cjsatuforc/MiniMega2560/2560v10_2e_3vREG.jpg

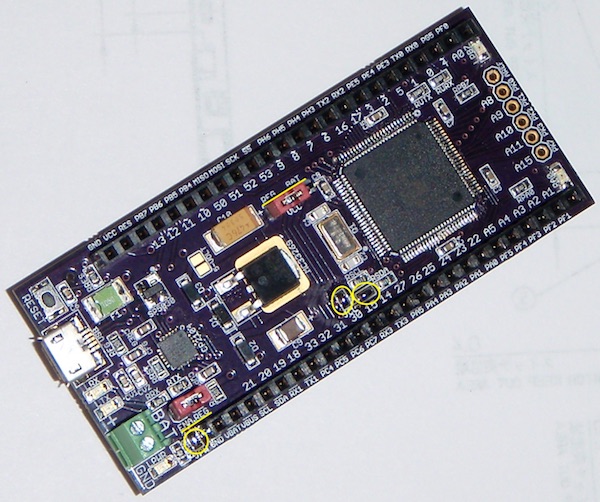
2560v10_2e_3vREG.jpg
