cjsatuforc/MiniMega2560/2560v10_2e_5volt.jpg

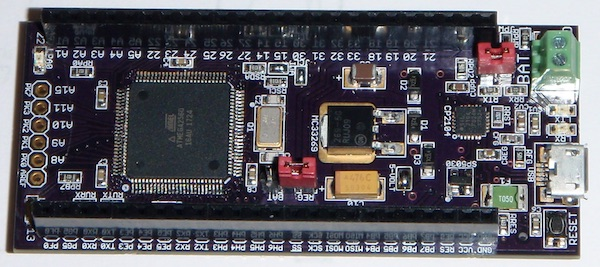
2560v10_2e_5volt.jpg
