cjsatuforc/MiniMega2560/2560v10_2e_NoReg.jpg

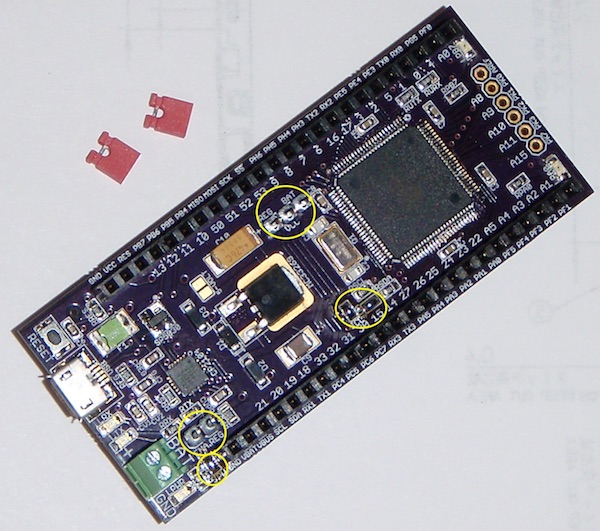
2560v10_2e_NoReg.jpg
