cjsatuforc/MiniMega2560/MiniMega2560NetCardPoE.jpg

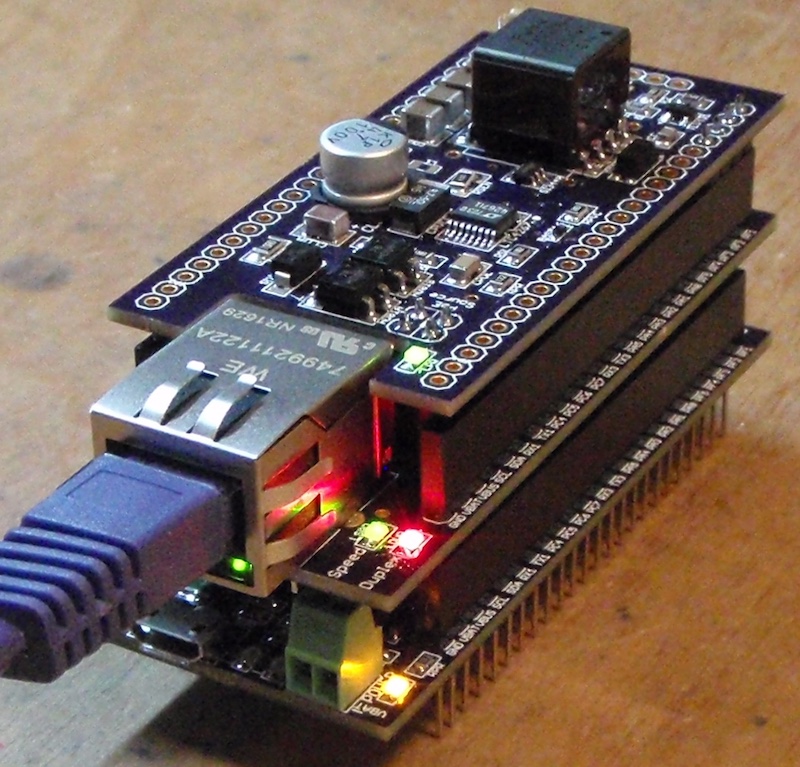
MiniMega2560NetCardPoE.jpg
