cjsatuforc/MiniMega2560/sleep/2560_2e_Battery.jpg

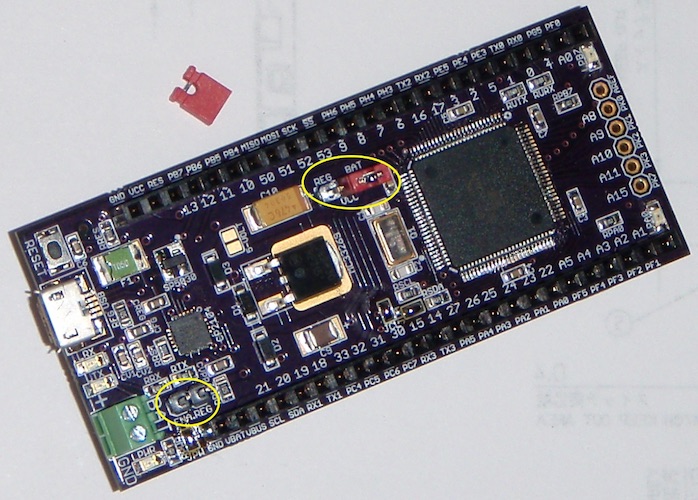
sleep/2560_2e_Battery.jpg
