cjsatuforc/MiniMega2560/sleep/sleep_pix1_ma.jpg

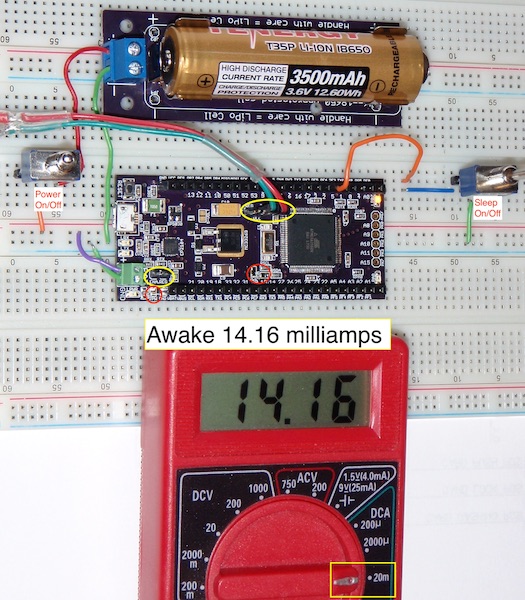
sleep/sleep_pix1_ma.jpg
