cjsatuforc/MiniMega2560/sleep/sleep_pix2_ua.jpg

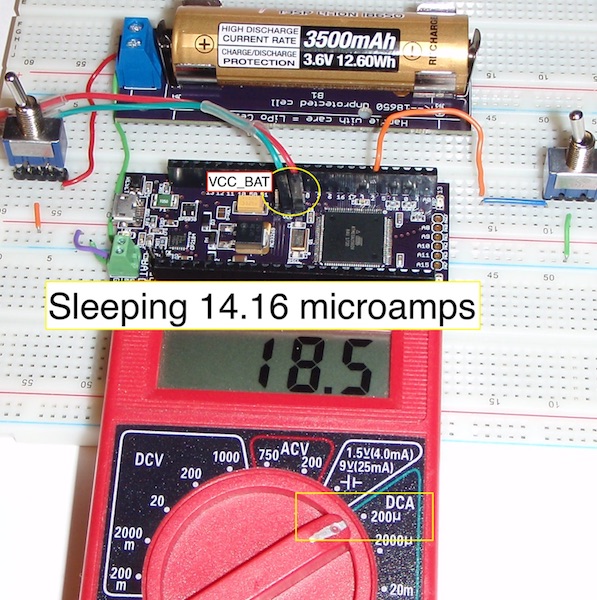
sleep/sleep_pix2_ua.jpg
