cjsatuforc/MiniMega2560/vcc_to_href_jumper.jpg

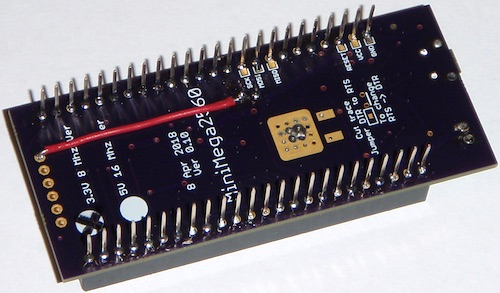
vcc_to_href_jumper.jpg
