cjsatuforc/MiniMega2560/MiniMega2560v10_2e.SC.pdf

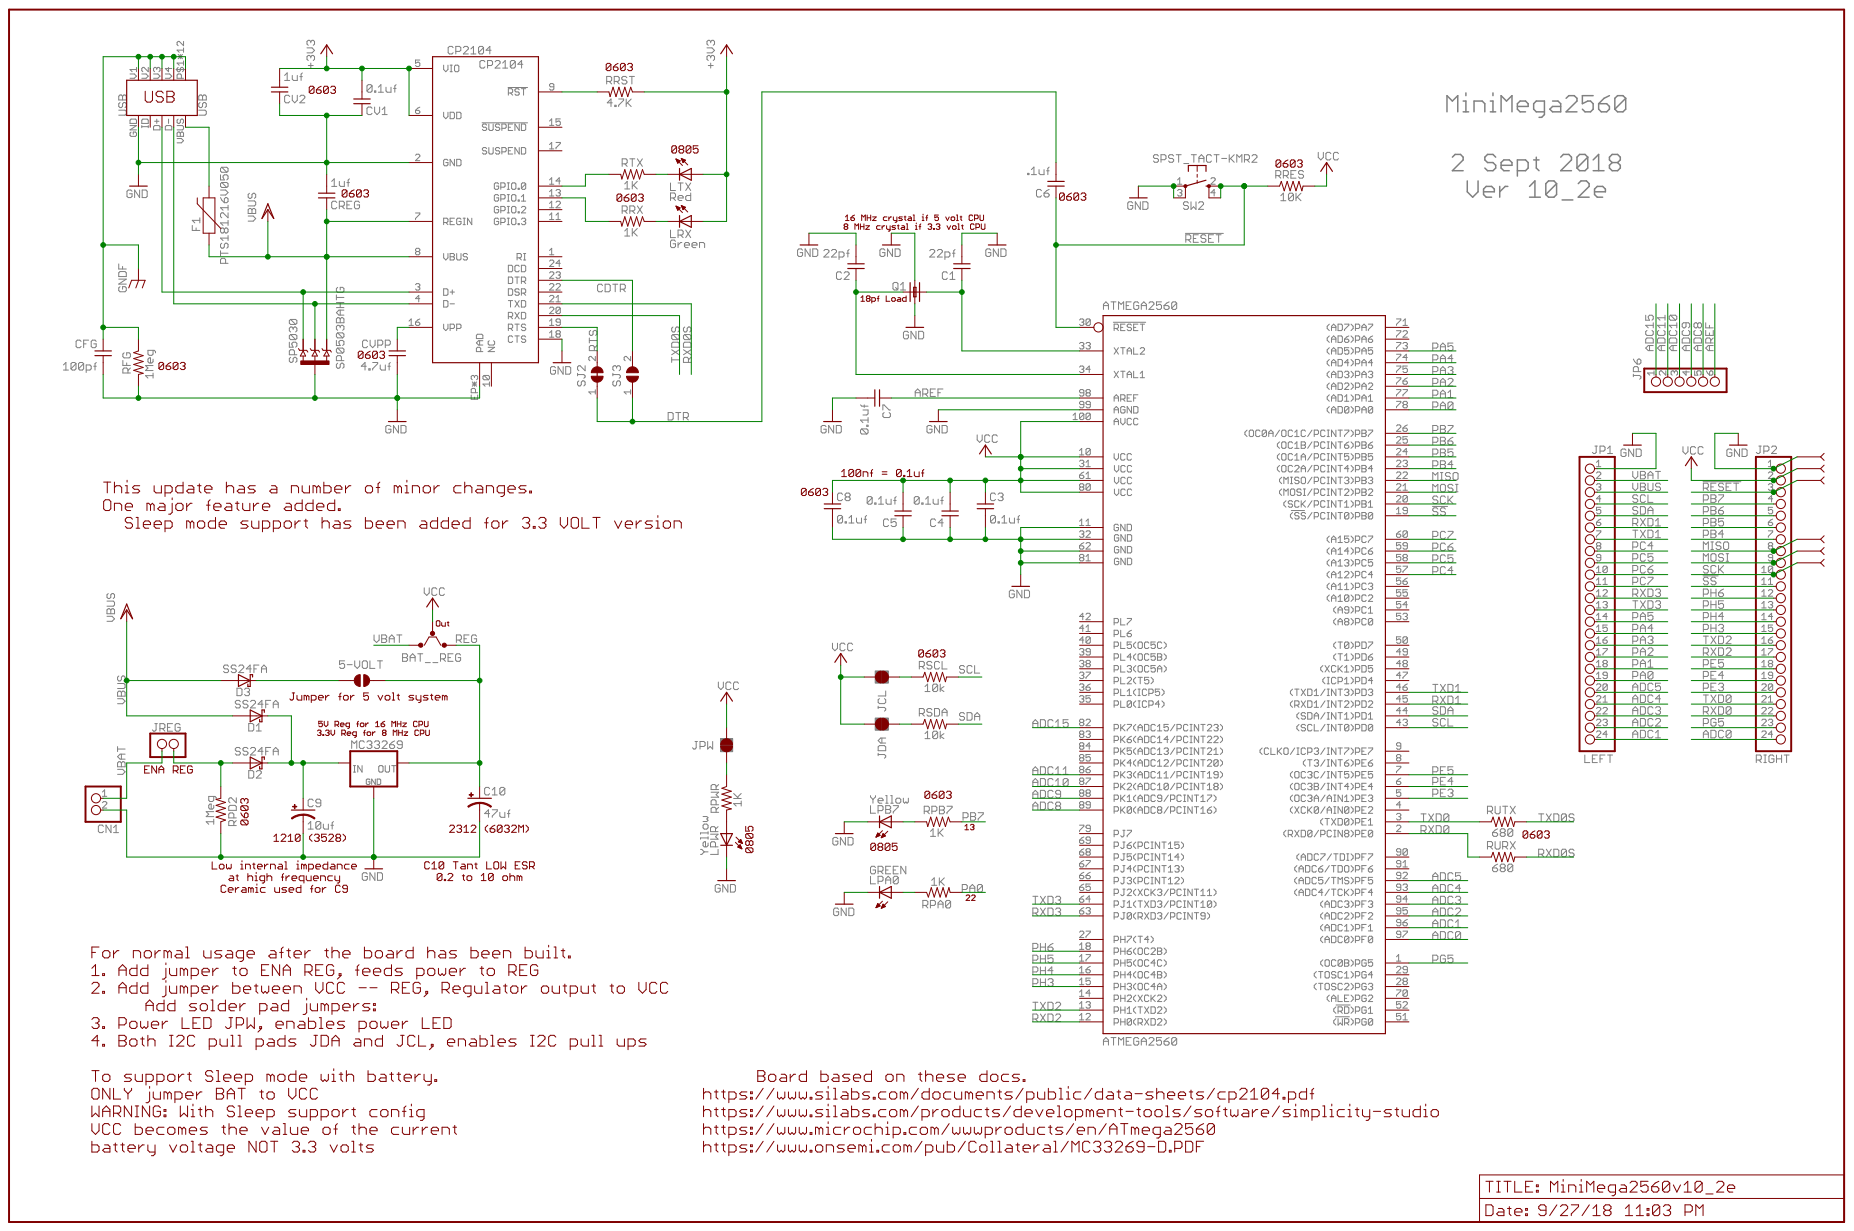
[picture p16: page 1]
