cjsatuforc/MiniMega2560/MiniMega2560v10_2e_BD.pdf

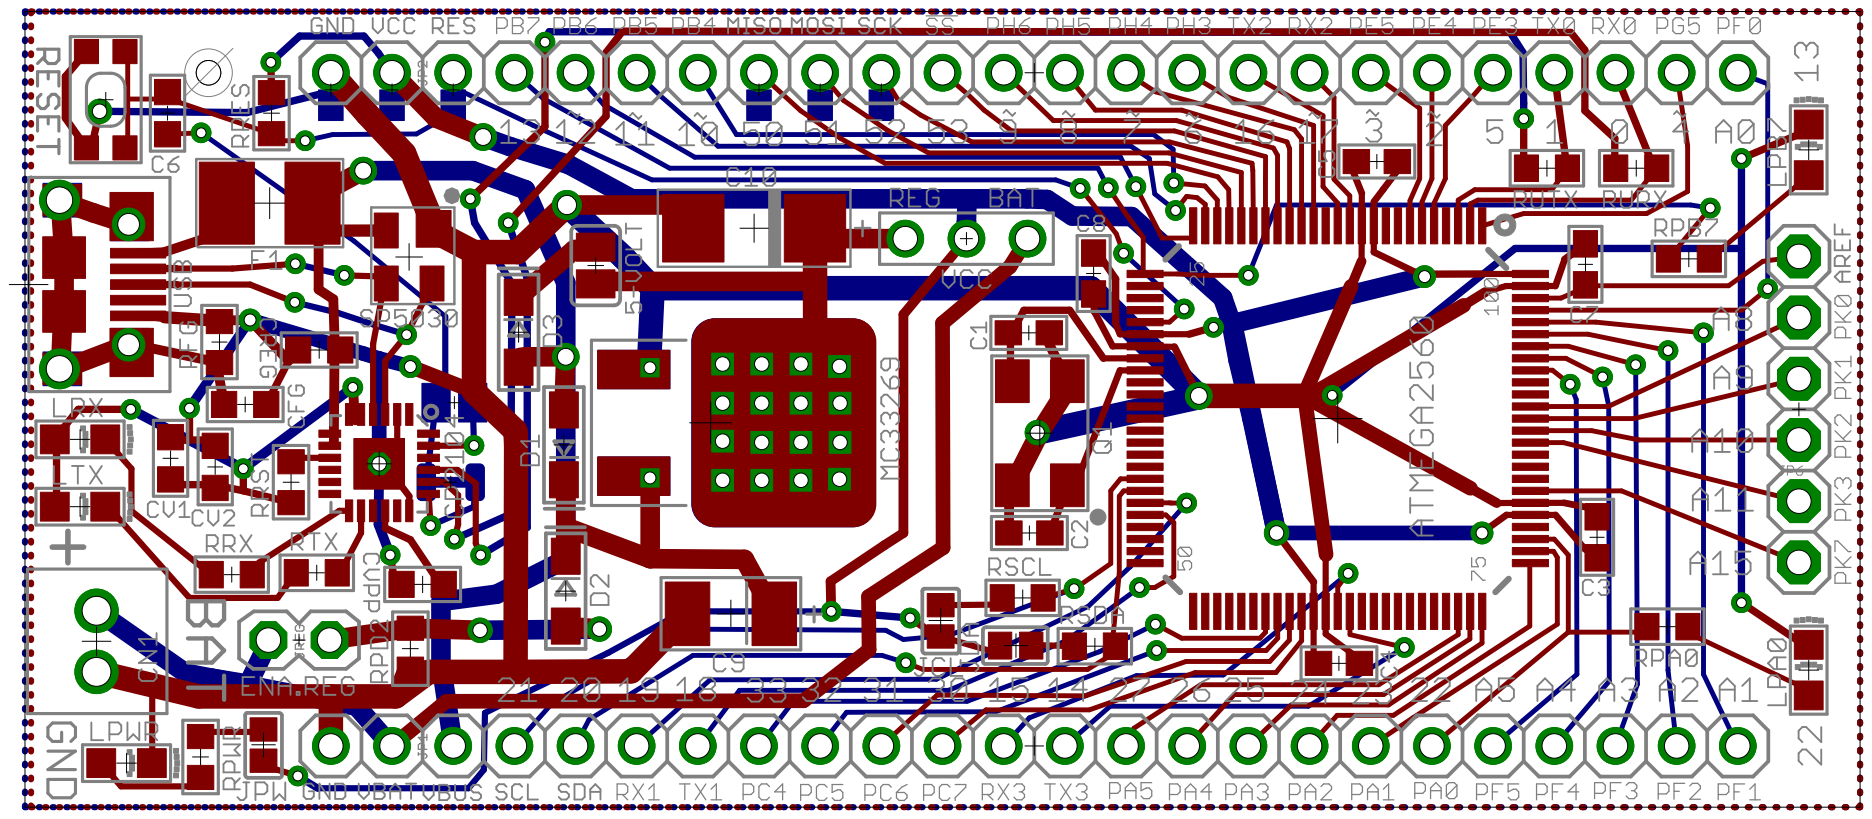
[picture p17: page 1]
