cjsatuforc/MiniMega2560/Retired/MiniMega2560v10.1sc_RETIRED.pdf

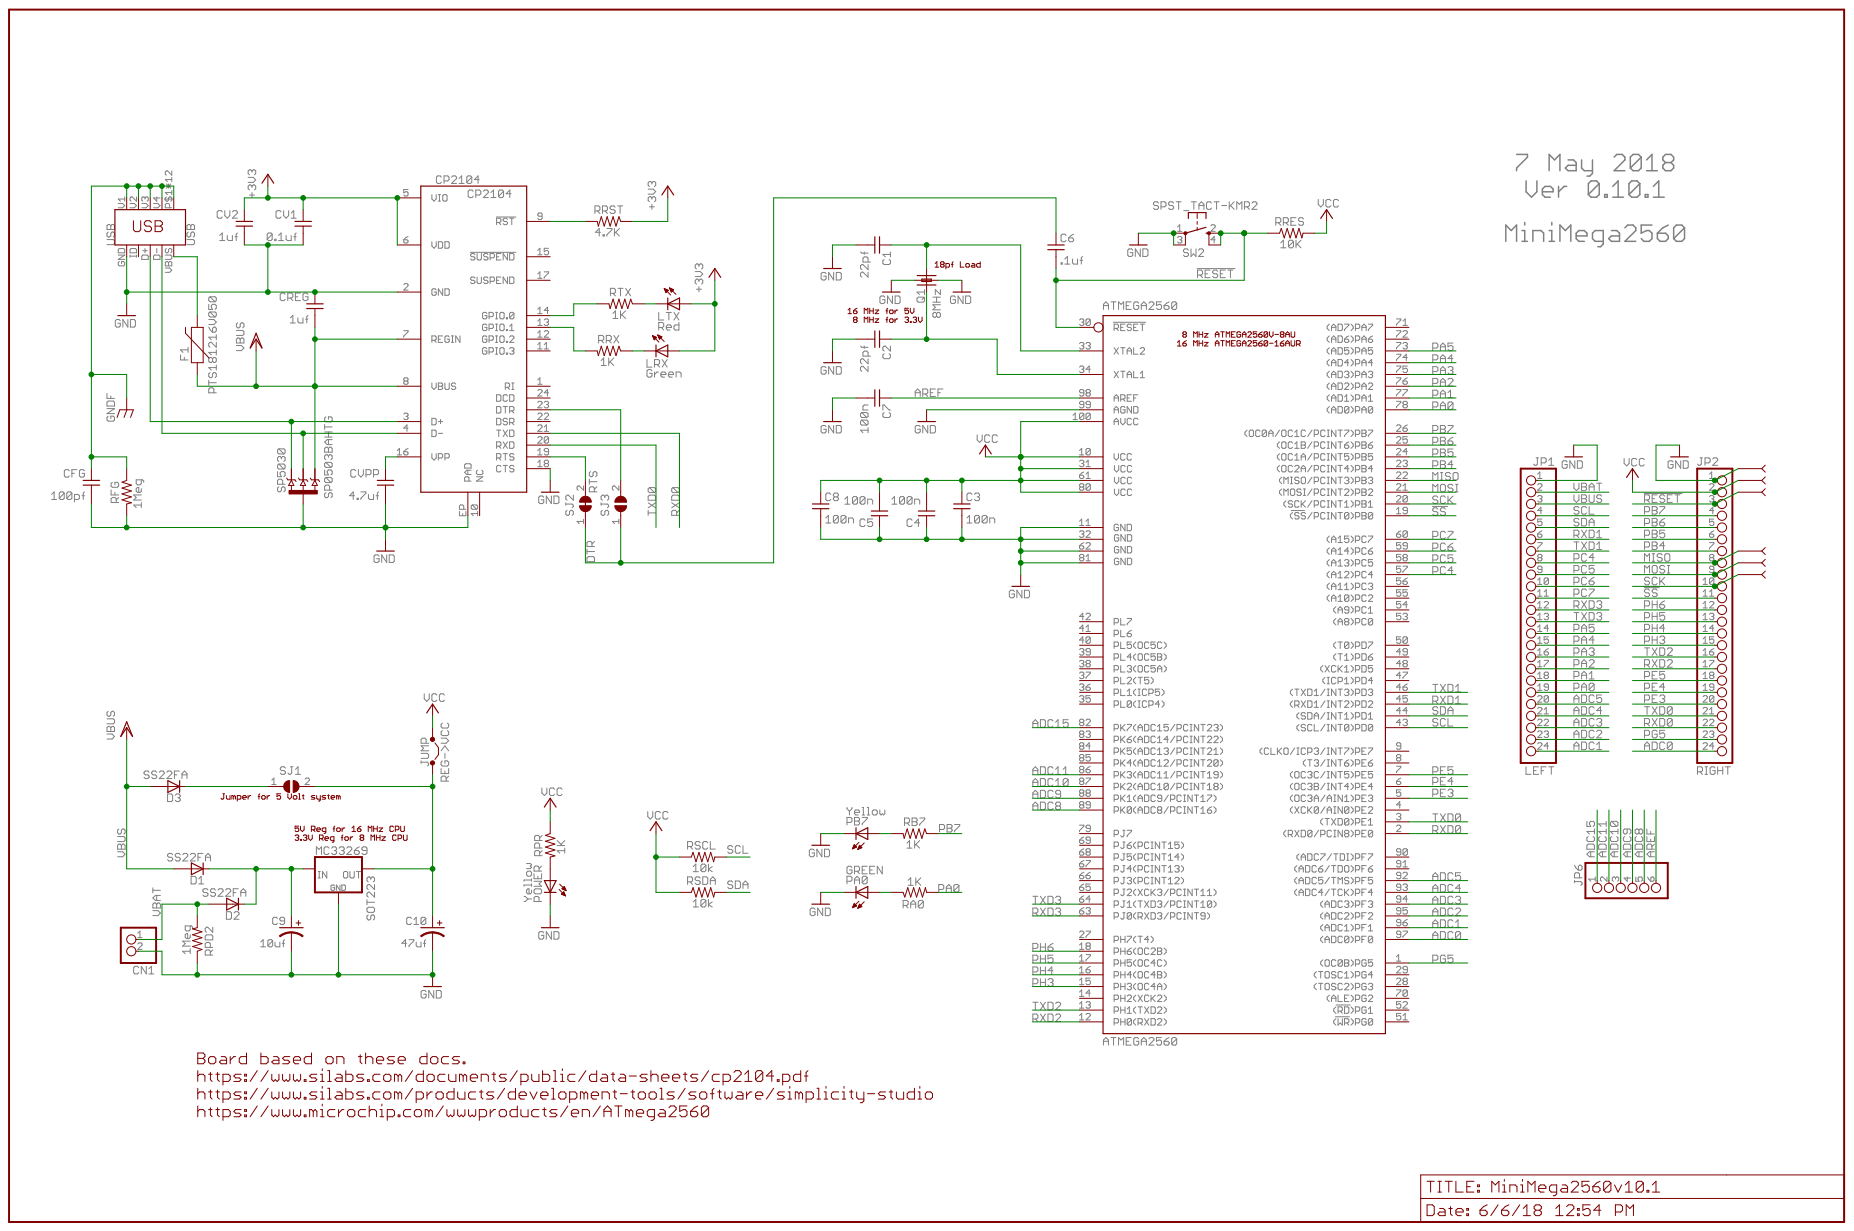
[picture p18: page 1]
