cjsatuforc/MiniMega2560/Retired/MiniMega2560v10.1_bd_RETIRED.pdf

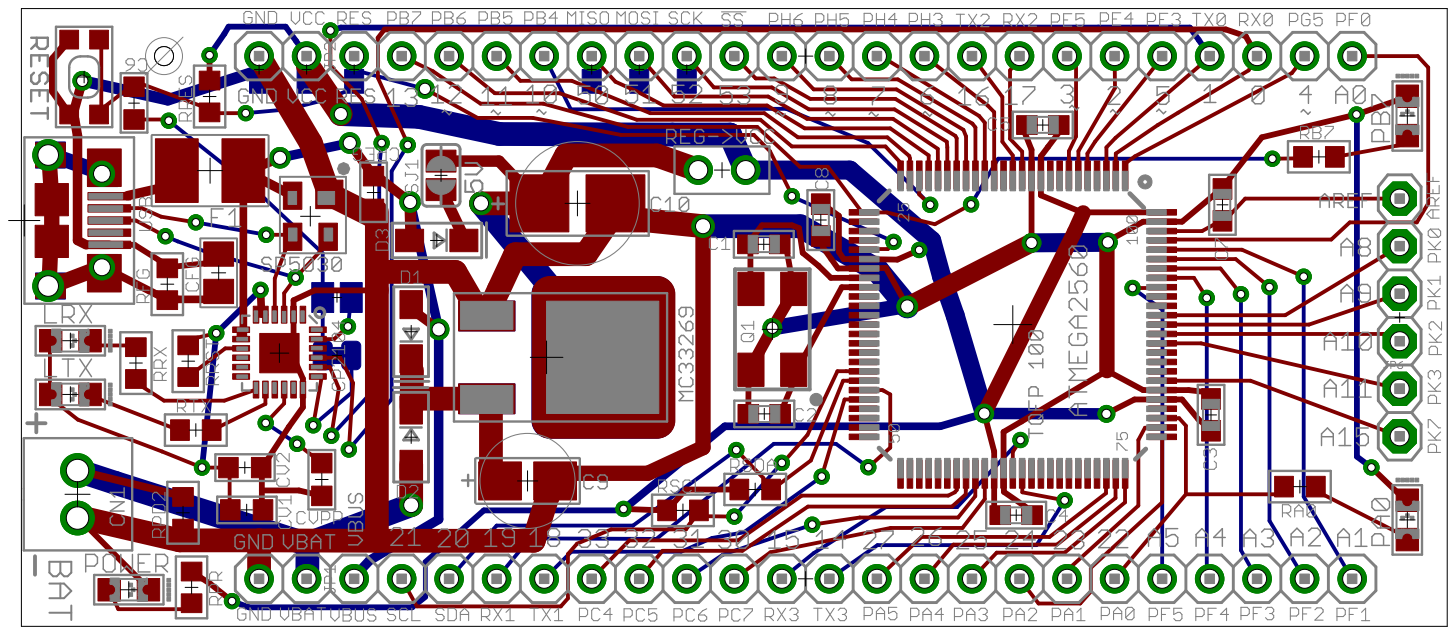
[picture p19: page 1]
