cjsatuforc/MiniMega2560/TestRig.jpg

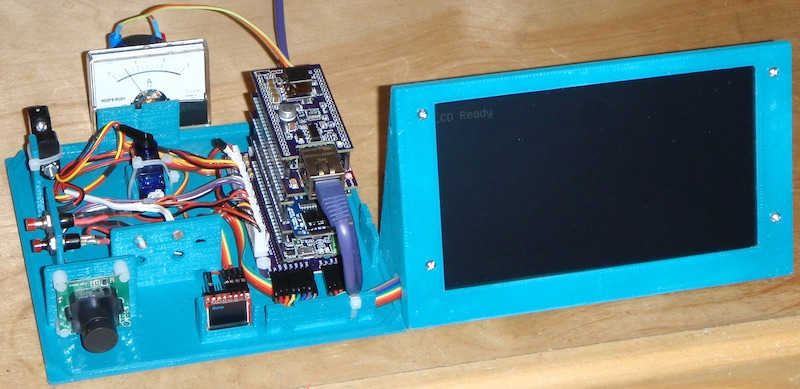
TestRig.jpg
